AlfonsoRodr/Empotrados/Documentation.png

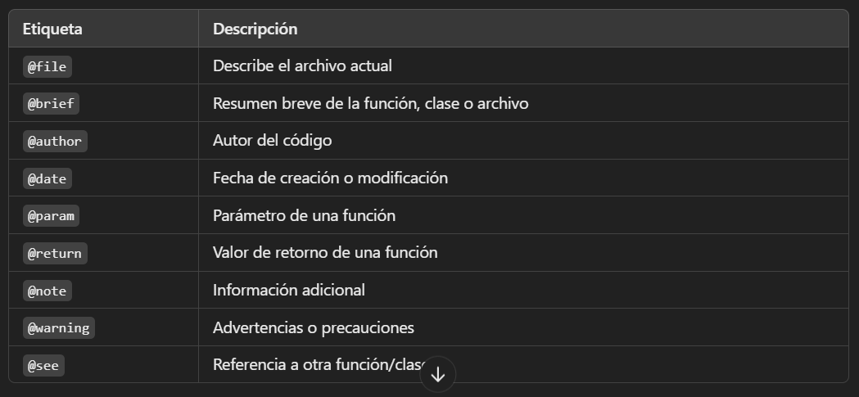
Documentation.png
