AlfonsoRodr/Empotrados/PracticaObligatoriaEmp/ConectionDiagram.png

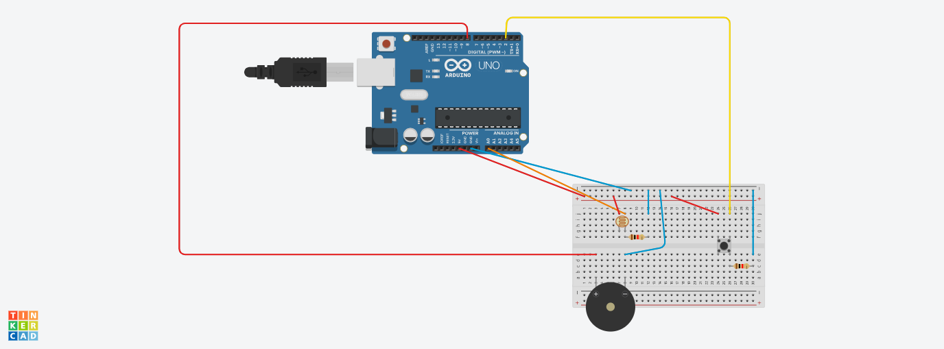
PracticaObligatoriaEmp/ConectionDiagram.png
