AlfonsoRodr/Empotrados/Material de Apoyo/Comunicación Serial/SerialCommunication.png

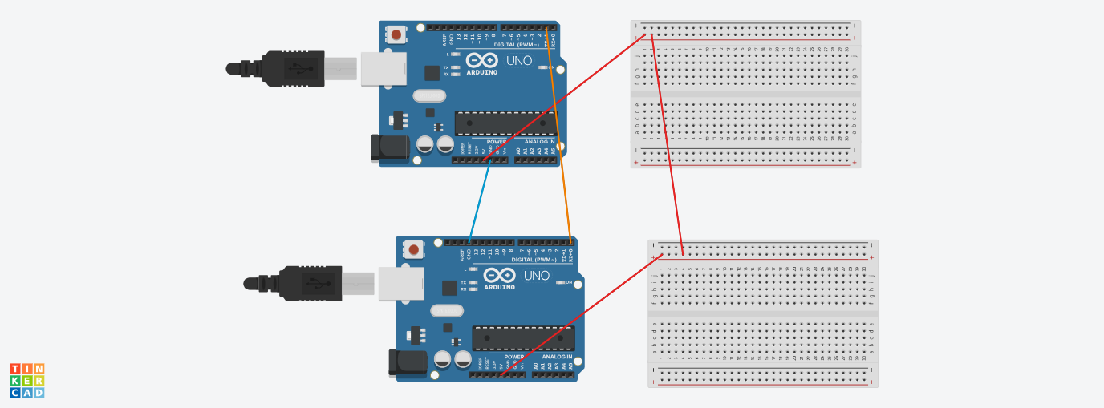
Material de Apoyo/Comunicación Serial/SerialCommunication.png
