AlfonsoRodr/Empotrados/Material de Apoyo/DHT11/DHT11.png

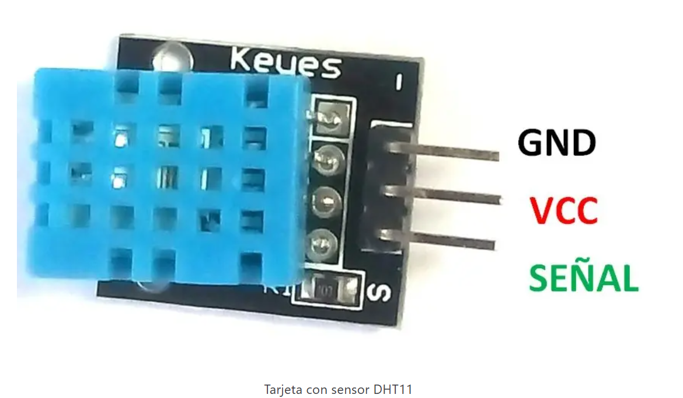
Material de Apoyo/DHT11/DHT11.png
