AlfonsoRodr/Empotrados/Material de Apoyo/IR/Esquema Electrico IR.png

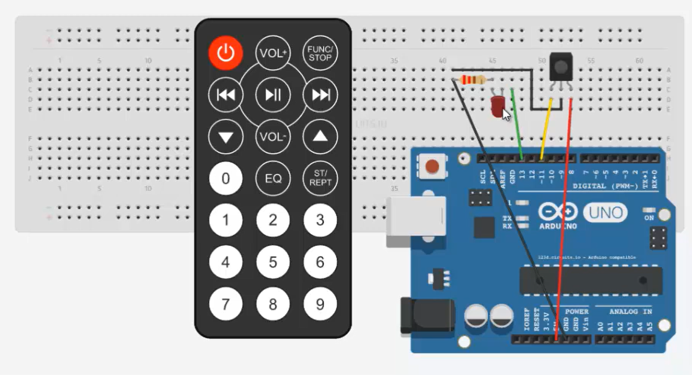
Material de Apoyo/IR/Esquema Electrico IR.png
