AlfonsoRodr/Empotrados/Material de Apoyo/Keypad/teclado_bb.png

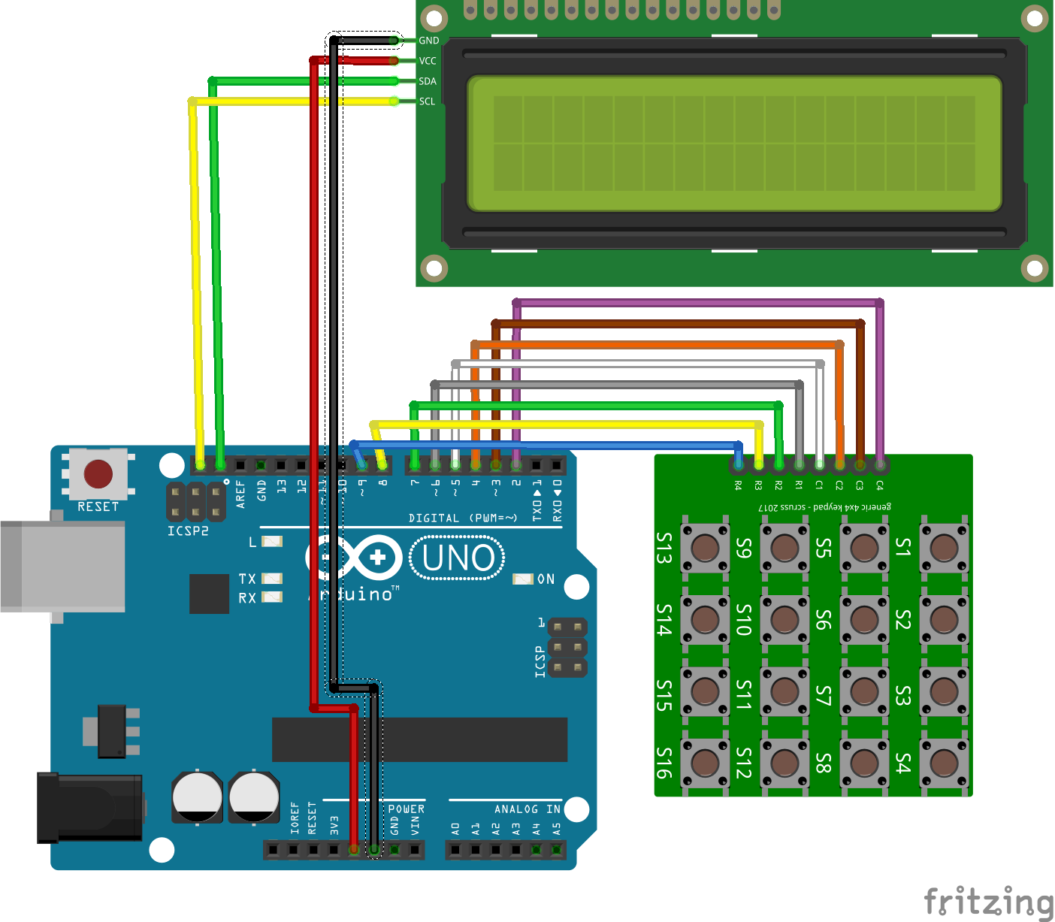
Material de Apoyo/Keypad/teclado_bb.png
