AlfonsoRodr/Empotrados/Material de Apoyo/LCDScreen/Esquema Electrico LCD.png

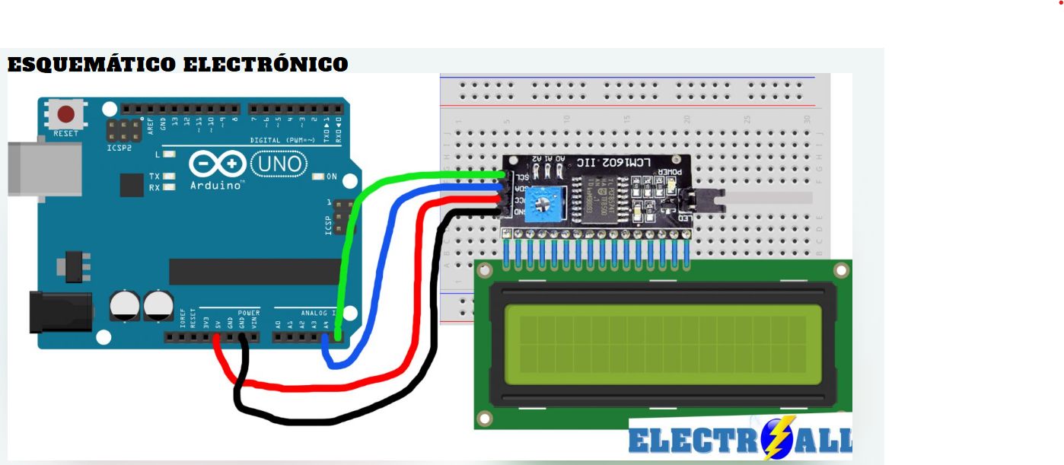
Material de Apoyo/LCDScreen/Esquema Electrico LCD.png
