AlfonsoRodr/Empotrados/Proyecto/Diagrams/Electric/Bloque1Elec.pdf

A

1 | 2 | 3 | 4 | 5 | 6

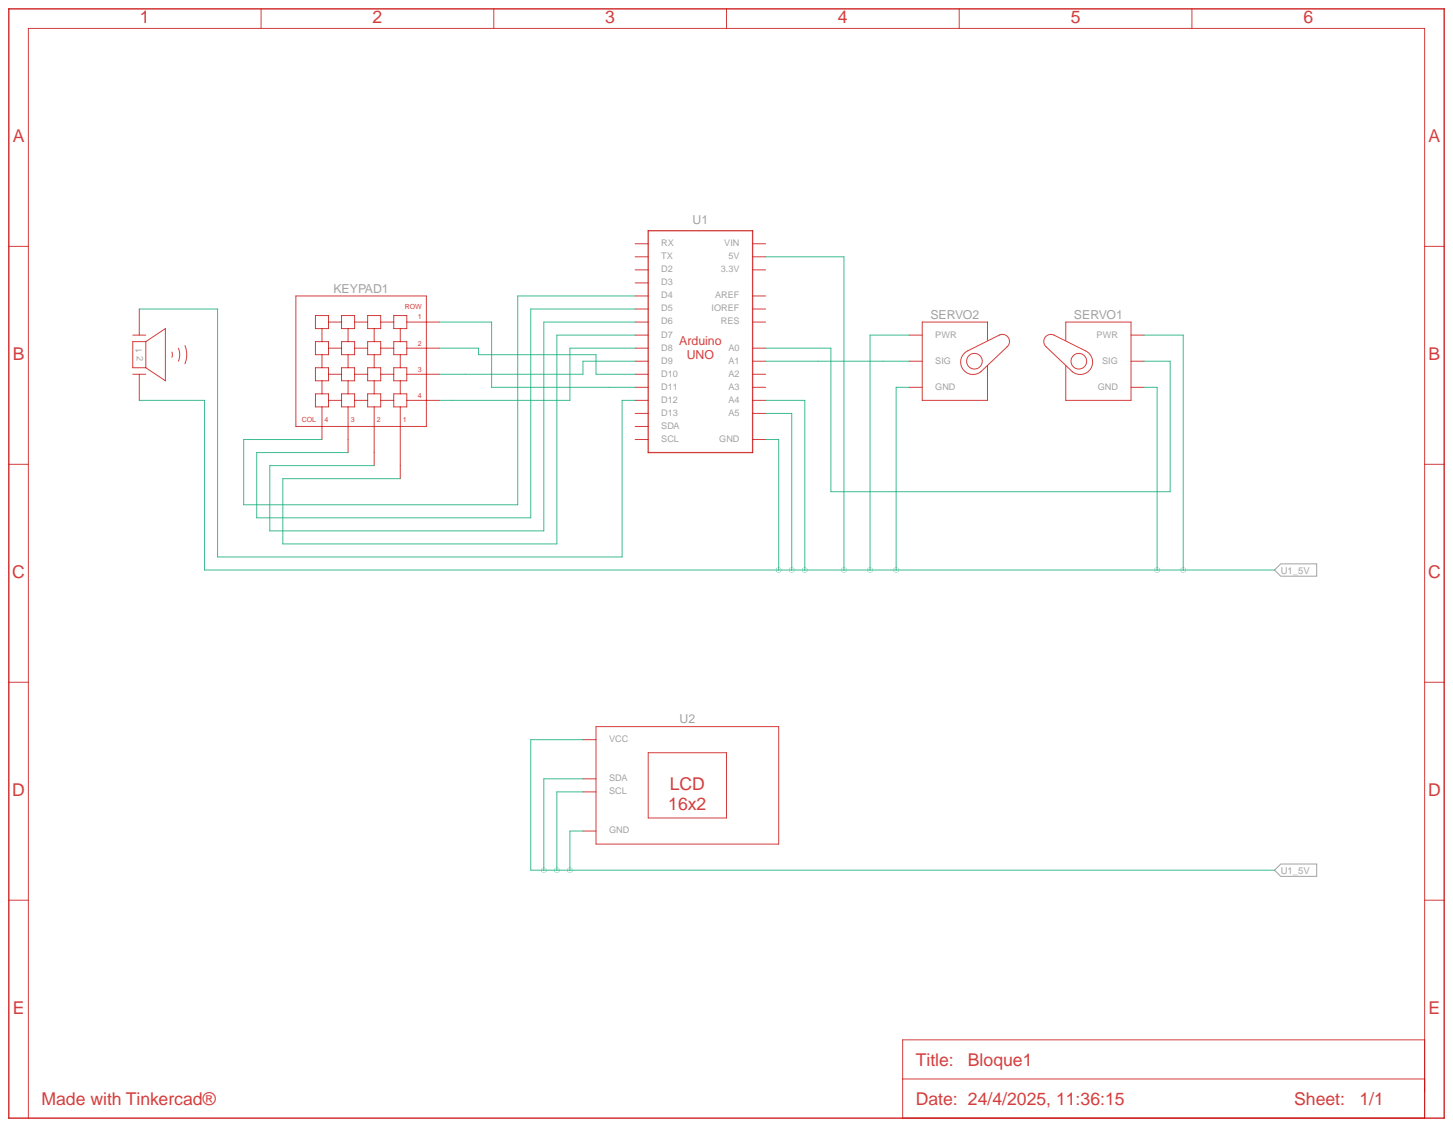
[picture p13: page 1]
