AlfonsoRodr/Empotrados/Proyecto/Diagrams/Electric/Sistema.pdf

A

1 | 2 | 3 | 4 | 5 | 6

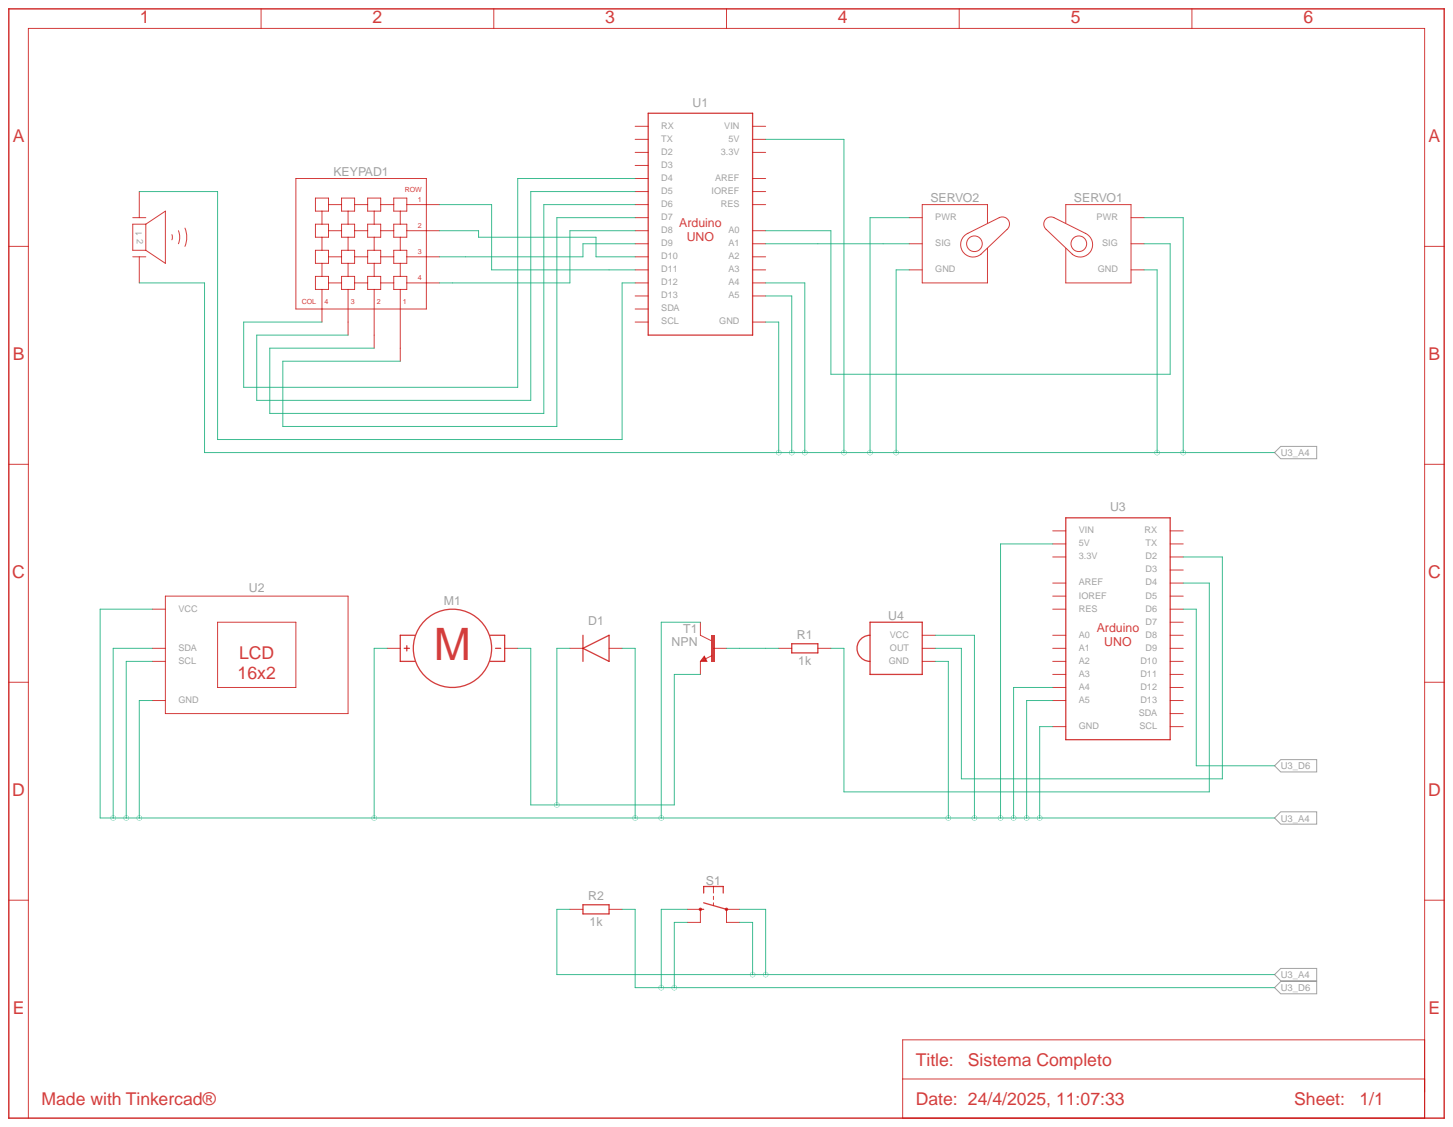
[picture p14: page 1]
