AlfonsoRodr/Empotrados/Proyecto/Diagrams/Electric/Bloque2.pdf

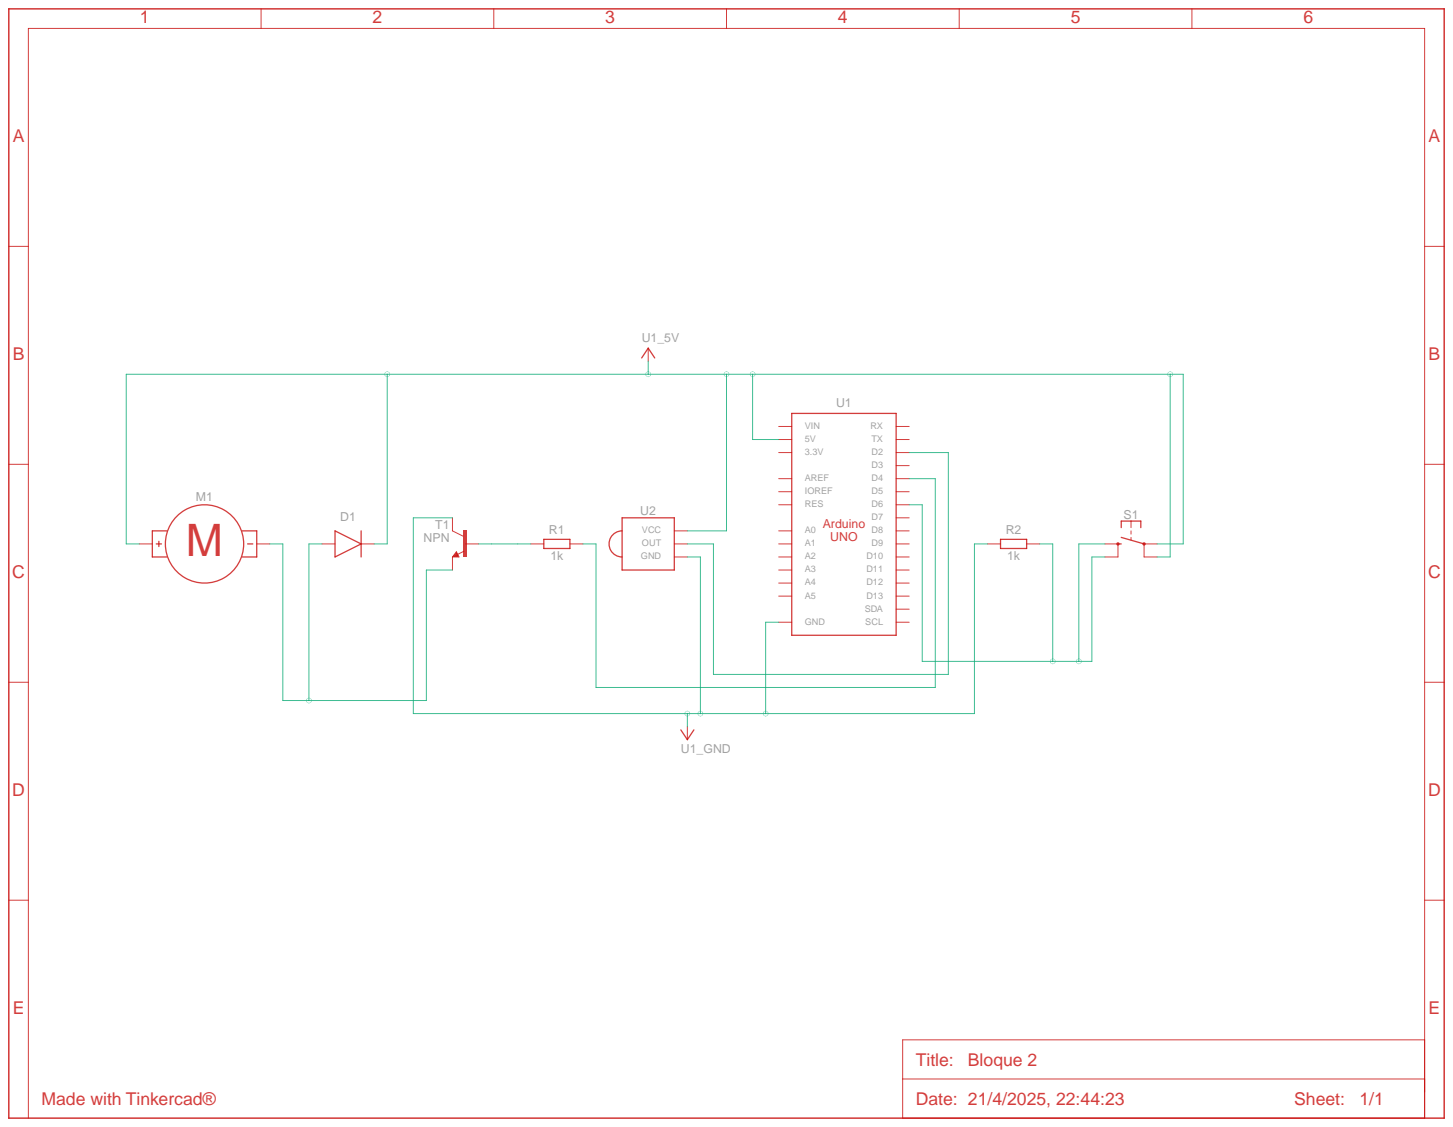
[picture p15: page 1]
