AlfonsoRodr/Empotrados/(commit log)

2025-03-25 Added some Fingerprint sensor examples
2025-04-11 Add the Fan and Temperature part
2025-04-12 Update Phase 2 (see cmt)
    [partitions.csv]
2025-04-16 Update TemperatureFanController
2025-04-19 included MotorLock to the main program
2025-04-19 Add Fingerprint Tries
2025-04-20 Fix Fingerprint
2025-04-20 Add the missing doc
    [FingerprintEsp.h, PasswordManager.h, TemperatureFanController.h]
2025-04-20 Fix Temperature_Treshold value
2025-04-21 Add the missing doc for MotorLock
    [MotorLock.cpp, MotorLock.h]
2025-04-23 Add I2C Communication
2025-04-27 Refactorize CameraWebServer
2025-04-28 Update the motors angles
